waggle-sensor/wagman/boards/v2/README.md

# Wagman v2
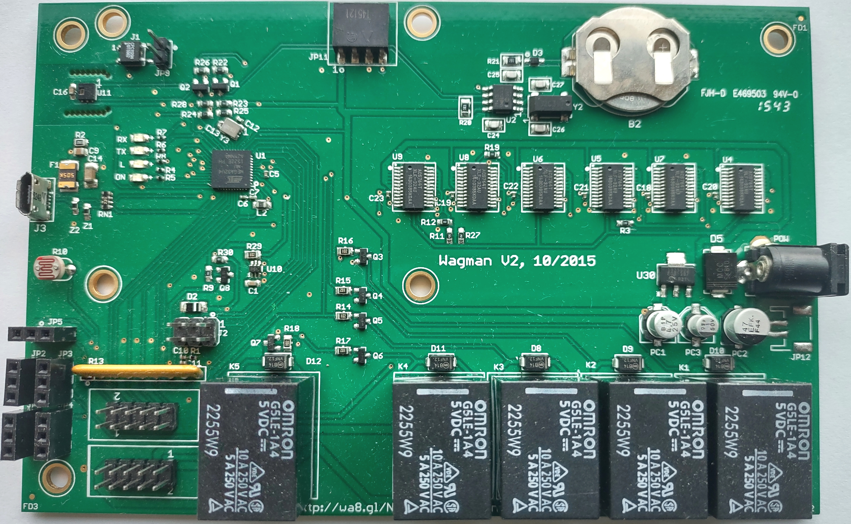
[picture p2: boards/v2/resources/wagman_v2-2.jpg]
</br>
Wagman v2 ([v2.1](https://github.com/waggle-sensor/wagman/raw/master/boards/v2/resources/wagman_v2-1.jpg) and [v2.2](https://github.com/waggle-sensor/wagman/raw/master/boards/v2/resources/wagman_v2-2.jpg) ) is built around a [ATmega32U4](https://www.microchip.com/en-us/product/ATmega32U4). It provides 5 channel power control using relays, current measurement (ACS764), Temperature and Humidity sensor (HTU21D and HIH4030), RTC (MCP79412), light sensor and 5V outputs. Wagman v2 is a prototype and system demonstrator, and is built to work with Odroid [C1+](https://www.hardkernel.com/shop/odroid-c1/) and [XU4](https://www.hardkernel.com/shop/odroid-xu4-special-price/) SBCs, providing special circuits for mnaging boot-media.
