waggle-sensor/wagman/boards/v4/firmware/develop/README.md

# Develop Notes

Currently porting communication to waggle protocol.
