waggle-sensor/wagman/boards/v2/supportcodes/Notes/Program SysMon.odt

- Connect AVR programmer to ICSP header on SysMon board (and to USB on your computer)
- Call avrdude program
  - terminal >> avrdude -option1 -option2 …
    - The following is an example of what Arduino calls to program a chip without a bootloader:
      - /opt/arduino-1.6.4/hardware/tools/avr/bin/avrdude -C/opt/arduino-1.6.4/hardware/tools/avr/etc/avrdude.conf -v -patmega32u4 -cstk500v2 -Pusb -Uflash:w:/home/danny/repos/git/waggle/wagman/manager/sysmanager/bin/sysmanager.cpp.hex:i
      - For an explanation of those options, see avrdude documentation
      - The .hex file is the firmware file that you're trying to burn onto the chip
- If you'd like to burn the Arduino bootloader onto the chip:
  - Connect AVR programmer
  - Launch Arduino IDE (you may need sudo)
  - Go to Tools > Burn Bootloader
