waggle-sensor/wagman/boards/v3/manager/qa_testing/design_dev_tests/Wagman_C1P_Bootswitch/README.md

# Test Scope and Coverage

This test evaluates the following aspects of Wagman system design. </br>
*   The ability to connect the boot-pins of the C1+ or isolate them toward
    changing the primary boot-up media. </br>
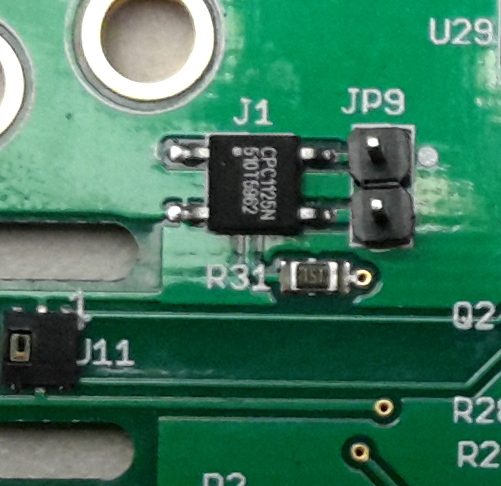
[picture p9: boards/v3/manager/qa_testing/design_dev_tests/Wagman_C1P_Bootswitch/resources/C1PBootSwitch.jpg]

*   Default boot media must be uSD, which is achieved by connecting the bootpins.
</br>

# Test Setup Procedure

*This test requires additional equipment. A multi-meter with continuity test capability in audible beep mode
to signify continuity is required.*

## Test Events Timeline
* The test starts with a Wagman that is not connected to power or the QA computer.
* Wagman is loaded with firmware and the toggling ability is tested.

## Electrical Connection
*  Connect micro-USB cable between Wagman's J3 and QA computer.
*  Connect 5V DC power to Wagman.

__Please make sure only the Wagman under test is connected to the QA computer. No other Wagman or Arduino Micro/derivatives can be connected at this time.__

## Testing Procedure
*   On an unpowered Wagman that is not connected to the QA computer, check the continuity between the two
    pins of JP9.</br>
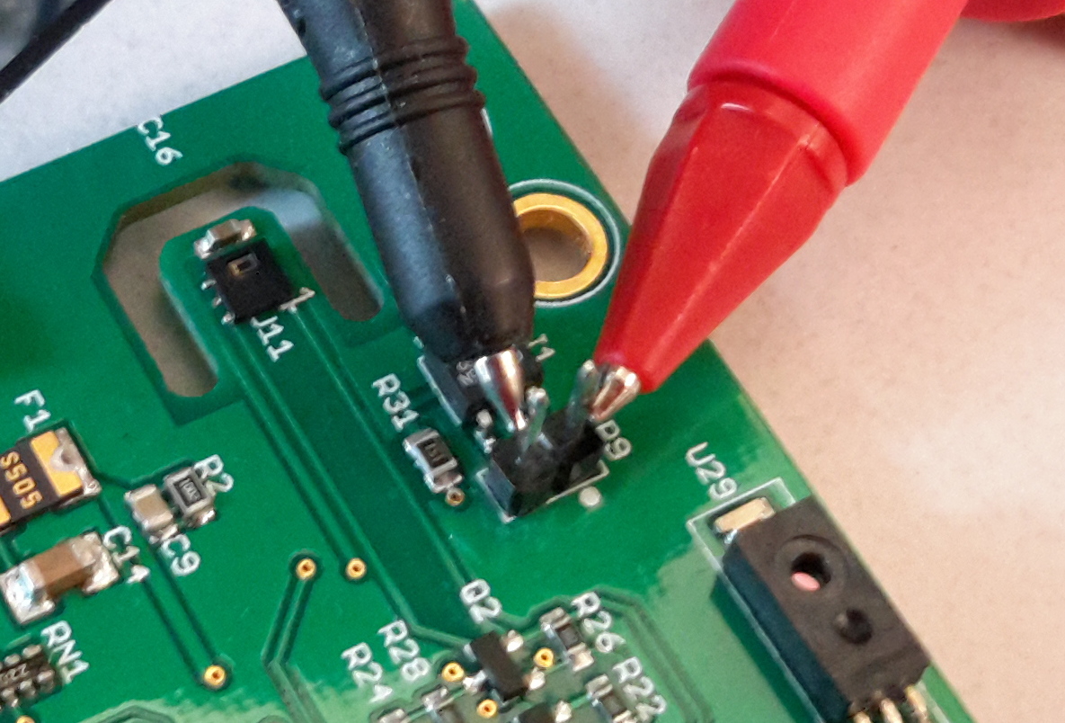
[picture p10: boards/v3/manager/qa_testing/design_dev_tests/Wagman_C1P_Bootswitch/resources/C1P_BootSelect.jpg]
 	
*   Connect the Wagman to QA computer and power it ON.
*   Start the second phase of the test by issuing the command *make test* in the Wagman subfolder
    and follow the on-screen prompts.

    __To exit the screen session created for the test, press Control+a, followed by k and y.__

## Test Log
This test is evaluated and scored on the __Wagman QA Scoresheet__.

# Success Criteria
The test is considered __PASSED__ if all the subtests under the Wagman C1P Boot Selector Test pass.
