waggle-sensor/wagman/boards/v3/manager/qa_testing/design_dev_tests/Wagman_Sensors/README.md

# Test Scope and Coverage

This test evaluates the following aspects of Wagman system design. </br>
*   The proper wiring of on-board sensors.
    -   HTU21D</br>
    
    -   HIH4030</br>
    
    -   Five Thermistors, four of which are sampled using MCP3428 A/D converter</br>
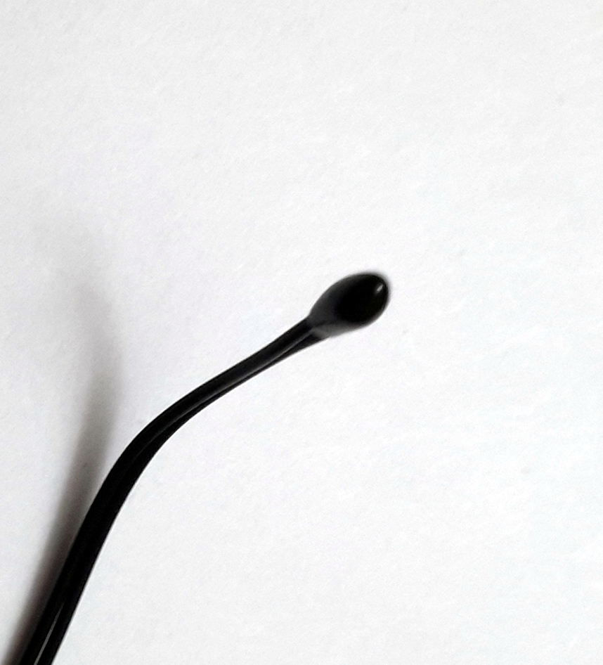
[picture p22: boards/v3/manager/qa_testing/design_dev_tests/Wagman_Sensors/resources/Thermistor.jpg]
    
    -   Optoresistor</br>
    
*    The functioning of the on-board sensors.
</br>

# Test Setup Procedure

## Test Events Timeline
* Wagman is loaded with firmware and the sensor test is conducted.

## Electrical Connection
*  Connect the two leads of the thermistors to PINS 5 and 6 of J5, J6, J7, J8 and J9 as shown below.
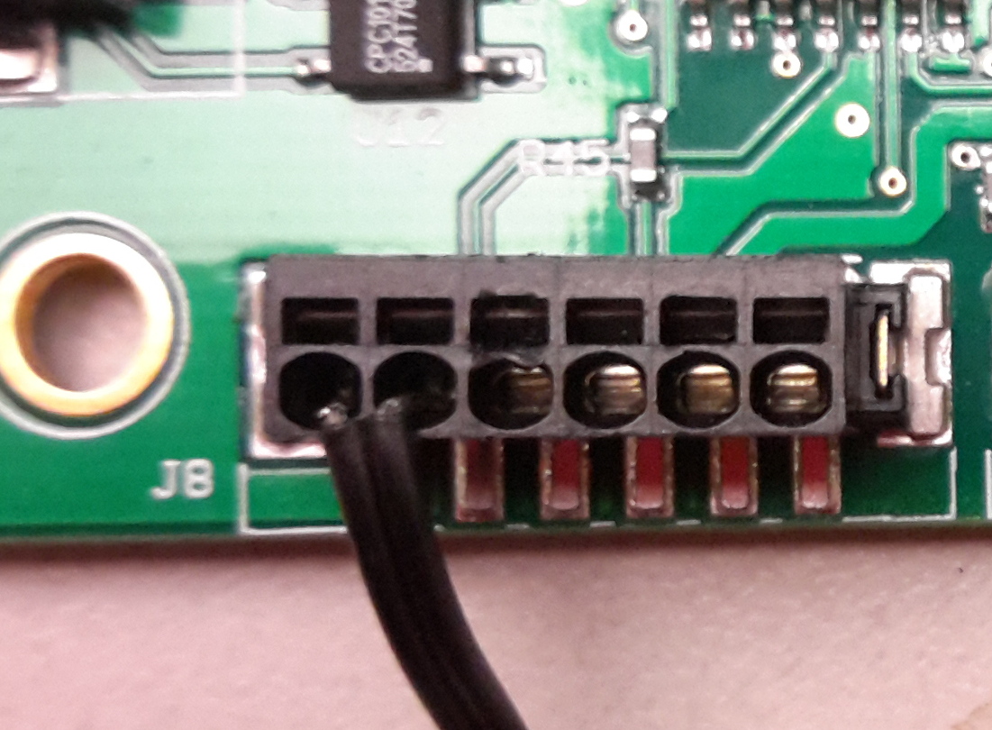
[picture p23: boards/v3/manager/qa_testing/design_dev_tests/Wagman_Sensors/resources/Thermistor_wiring.jpg]

*  Connect micro-USB cable between Wagman's J3 and QA computer.
*  Connect 5V DC power to Wagman.

__Please make sure only the Wagman under test is connected to the QA computer. No other Wagman or Arduino Micro/derivatives can be connected at this time.__

## Testing Procedure
*   Start the test by issuing the command *make test* in the Wagman subfolder
    and follow the on-screen prompts.

    __To exit the screen session created for the test, press Control+a, followed by k and y.__

## Test Log
This test is evaluated and scored on the __Wagman QA Scoresheet__.

# Success Criteria
The test is considered __PASSED__ if all the subtests under the Environmental Sensors Test pass.
