waggle-sensor/wagman/boards/v2/supportcodes/Notes/WagMan Tests.odt

WagMan Tests

Test Group | Test Description | Test Methodology | Pass/Fail
Primary boot sequence | Multiple attempts at primary boot sequence | Disconnect heartbeat from NC until SysMon tries another boot. Reconnect heartbeat and see if everything boots. | pass
| Going to sleep | Disconnect heartbeat from NC and leave it until SysMon goes to sleep. | fail
| All EEPROM defaults set correctly | Go thru list and make sure every variable is being assigned a default. | pass
| Parameters transferred correctly from NC | Print the value of an EEPROM read after receiving the parameters. | pass
| Time transferred correctly from NC | Print the time received from NC. | pass
Boot SysMon | Bad power | Set default EEPROM value to zero. | pass
| Bad environment | Set default EEPROM values to something outside the ambient range. | pass
Boot NC | Bad power | Set default EEPROM value to zero. | pass
| Bad power resulting in permanent disable | With the EEPROM value at zero, let SysMon disable NC. Reboot SysMon and see if it attempts to boot NC. | pass
| Bad environment | Set default EEPROM values to something outside the ambient range. | pass
| Bad temperature | Set default EEPROM values to something outside the ambient range. | pass
| Bad heartbeat | Disconnect heartbeat from NC and wait for power cycle. Reconnect heartbeat and see if it boots correctly. | pass
Boot ethernet switch | Bad power | Set default EEPROM value to zero. | pass
| Bad power resulting in permanent disable | With the EEPROM value at zero, let SysMon disable the switch. Reboot SysMon and see if it attempts to boot the switch. | pass
| Bad temperature | Set default EEPROM values to something outside the ambient range. | pass
Boot guest nodes (1, 2, 3) | Bad power | Set default EEPROM value to zero. | pass
| Bad power resulting in permanent disable | With the EEPROM value at zero, let SysMon disable GN. Reboot SysMon and see if it attempts to boot GN. | pass
| Bad temperature | Set default EEPROM values to something outside the ambient range. | pass
| Bad heartbeat | Disconnect heartbeat from GN and wait for power cycle. Reconnect heartbeat and see if it boots correctly. | pass
Main loop | Status report | Verify contents of status report received by NC. | pass
| Time report | Verify contents of time report received by NC. | pass
| Problem report | Verify contents of problem report received by NC. Some of the other tests should cause problem reports to be sent. | pass
| All timeouts being responded to | Cause each timeout by setting values to something ridiculous and overriding boot checks. | pass
| Reboot devices | Cause a timeout for each device and see if it SysMon reboots it after awhile. Also need to make sure normal operation resumes smoothly after the delay of waiting for something to boot. | pass
WagMan on NC | Heartbeat output | Verify heartbeat on the oscilloscope. | pass
| Store status report | Write status report to file. | pass
| Store problem report | Write problem report to file. | pass
| Configure (and communicate with SysMon) correctly | Run configure script on NC and see if status messages are eventually being sent to NC. | pass
