waggle-sensor/wagman/boards/v3/utils/manager/evaluator/README.md

<!--
waggle_topic=IGNORE
-->

The Wagman evaluation code documentation goes here.
