waggle-sensor/wagman/boards/v2/supportcodes/tests/evaluator/README.md

The Wagman evaluation code documentation goes here.
