waggle-sensor/wagman/boards/v4/errata/errata_V4.03.md

## Wagman 4.0 Power up and Testing 

## Enhancements:

* Add mechanism to read BOOTPULSE signal on the Atmel. We talked about using a high-impedence decoupler so the Atmel can't accidentally change the pin mode to output and affect BOOTPULSE's behavior.
