waggle-sensor/wagman/(threads)

Thread 1 (2016-06-24):

Watchdog / Bootloader Lockup

seanshahkarami, 2016-06-24:
Under some conditions, it seems like the watchdog enters a state such that immediately after the boot loader finishes, it reboots the device.

seanshahkarami, 2016-06-24:
This seems to have been solved by clearing the MCUSR flags before doing another `wdt_enable` in setup.

Closed 2016-06-24.

Thread 2 (2016-06-28):

Verify Port Address Mappings

seanshahkarami, 2016-06-28:
This is just a final reminder to walk through a check that all the sensors (thermistors / current sensors / heartbeat) and make sure that they are mapped correctly to the ports.

MuffinSpawn, 2016-09-23:
Issue moved to [waggle-sensor/development #27](https://github.com/waggle-sensor/development/issues/27) via [**ZenHub**](https://www.zenhub.com/)

Closed 2016-09-23.

Thread 3 (2016-06-28):

Need self check for PORF case.

seanshahkarami, 2016-06-28:
When the Wagman powers on, would like to add a quick self check and sensor range check. (The reason for doing it in this case, in particular, is that no devices will be on yet.)

MuffinSpawn, 2016-09-23:
Issue moved to [waggle-sensor/development #26](https://github.com/waggle-sensor/development/issues/26) via [**ZenHub**](https://www.zenhub.com/)

Closed 2016-09-23.

Thread 4 (2016-06-28):

Correct behavior for log messages sent in between commands.

seanshahkarami, 2016-06-28:
The logger current sends some info in between commands run in the Wagman shell. It's not a major issue since they just show up inside another command output but I would like to clean up the behavior of that.

MuffinSpawn, 2016-09-23:
Issue moved to [waggle-sensor/development #25](https://github.com/waggle-sensor/development/issues/25) via [**ZenHub**](https://www.zenhub.com/)

Closed 2016-09-23.

Thread 5 (2016-06-28):

Verify Boot Selection Cycle

seanshahkarami, 2016-06-28:
We just need to make sure that the devices are correctly cycled through the primary / secondary boot media on bad starts.

seanshahkarami, 2016-06-28:
Ok...part of this was me being dumb. I forgot that I temporarily removed the `incrementBootFailures` line when cleaning up the code...

seanshahkarami, 2016-06-28:
I just extended override boot media command. This should help with testing and also allow the node controller to make some choices about how devices will be started. 😄

MuffinSpawn, 2016-09-23:
Issue moved to [waggle-sensor/development #24](https://github.com/waggle-sensor/development/issues/24) via [**ZenHub**](https://www.zenhub.com/)

Closed 2016-09-23.

Thread 6 (2016-06-28):

Sync EEPROM memory layout in code and what's in layout document.

seanshahkarami, 2016-06-28:
Because of changes which have cropped up in development, I need to sync these pieces up.

MuffinSpawn, 2016-09-23:
Issue moved to [waggle-sensor/development #23](https://github.com/waggle-sensor/development/issues/23) via [**ZenHub**](https://www.zenhub.com/)

Closed 2016-09-23.

Thread 7 (2016-06-28):

Stop disabled devices showing up in logging / update loop.

seanshahkarami, 2016-06-28:
This is just a reminder for me to add a check against running things on disabled devices...

MuffinSpawn, 2016-09-23:
Issue moved to [waggle-sensor/development #22](https://github.com/waggle-sensor/development/issues/22) via [**ZenHub**](https://www.zenhub.com/)

Closed 2016-09-23.

Thread 8 (2016-06-28):

Split Stop / Reset Behavior

seanshahkarami, 2016-06-28:
I should make sure that the stop command also sets the disable flag on a device. And add a separate reset command.

MuffinSpawn, 2016-09-23:
Issue moved to [waggle-sensor/development #21](https://github.com/waggle-sensor/development/issues/21) via [**ZenHub**](https://www.zenhub.com/)

Closed 2016-09-23.

Thread 10 (2016-08-01):

SSH / Heartbeat

seanshahkarami, 2016-08-01:
Under what circumstances will a node controller continue to heartbeat Wagman but not be reachable via SSH?

seanshahkarami, 2016-08-01:
As with the modem, the heartbeat doesn't currently depend on the SSH tunnel.

MuffinSpawn, 2016-09-23:
Issue moved to [waggle-sensor/development #19](https://github.com/waggle-sensor/development/issues/19) via [**ZenHub**](https://www.zenhub.com/)

Closed 2016-09-23.

Thread 9 (2016-08-01):

Modem Hanging

seanshahkarami, 2016-08-01:
If the modem hangs, and only a power cycle will correct it, how does that scenario work?

seanshahkarami, 2016-08-01:
We could have the heartbeat process depend on more conditions being met such as the modem appearing to work, LAN connection showing up, etc.

Alternatively, if the NC detects something like this, it can just request to be reset.

MuffinSpawn, 2016-09-23:
Issue moved to [waggle-sensor/development #20](https://github.com/waggle-sensor/development/issues/20) via [**ZenHub**](https://www.zenhub.com/)

Closed 2016-09-23.

Thread 11 (2016-08-03):

Combined Current Behavior

seanshahkarami, 2016-08-03:
I just want to point out something I'd observed before but just realized a likely cause for.

I noticed that the current to the C1+ seemed to increase a little after the XU4 was powered on. After seeing the lights on the ethernet ports start blinking, I realized that it was likely a piece contributing to the "total being greater than the sum of parts". You can check this by unplugging the ethernet cable and seeing the current to the devices drop.

It's not a serious problem, but for anyone who ends up looking at this in the future, you'll probably witness this too. Ha...seems obvious now...

Closed 2016-08-03.

Thread 12 (2016-08-08):

Fail Safe Flag for Bootloader in EEPROM

seanshahkarami, 2016-08-08:
One feature request intended to make the flashing process a bit safer was to have a flag in EEPROM which the *bootloader* reads and uses to decide whether it should power on the node controller before running the main program.

The reason for this is that the bootloader is preserved when flashing the rest of the code on the Wagman, so it gives us a way to write a simpler, non-updatable piece to act as a failsafe for flashing the rest of the Wagman code. (For example, if we lost power during a flash, we could possibly be dead...)

seanshahkarami, 2016-08-08:
Bootloader reference code:
https://github.com/arduino/Arduino/tree/master/hardware/arduino/avr/bootloaders/atmega8

MuffinSpawn, 2016-09-23:
Issue moved to [waggle-sensor/development #18](https://github.com/waggle-sensor/development/issues/18) via [**ZenHub**](https://www.zenhub.com/)

Closed 2016-09-23.

Thread 13 (2016-08-15):

Verify that all reads have timeout.

seanshahkarami, 2016-08-15:
We realized that the MCP342 library did not include a timeout on the i2c read. This is corrected now, but we should verify that every case of this includes a timeout.

seanshahkarami, 2016-08-16:
This looks good now and additionally has a "breaker" feature that can disable i2c bus reads all together.

Closed 2016-08-16.

Thread 15 (2016-12-22):

Wagman V3.1 : Bootloader Install and Firmware Upgrade Issues

Rumpkie, 2016-12-22:
The latest run of wagman 3.1 boards and the older wagman 2s will not accept the latest version of the wagman software.

Symptoms:
the following error is generated:
```
avrdude: Expected signature for ATmega32U4 is 1E 95 87
Double check chip, or use -F to override this check.
```

The board will not accept the latest boot loader or any boot loader.

Rumpkie, 2016-12-22:
I have been able to get the bootloader to program on the ATMEGA32u4 by reducing the programmer's baud rate by editing the makefile and changing the `avrdude -B` flag from 1 to 2.
which drops the programming bit rate from 1Mhz to 500Khz.

While this did get passed the problem of burning the bootloader, it did not allow me to program the chips with the test software.  The issue becomes the command

`stty -F /dev/waggle_sysmon hupcl;`

which normally puts the ATMEGA32u4 into receive program mode doesn't seem to work, or doesn't seem to completely work. and while sometimes the avrdude can read the existing board it cannot seem to find the programmer or reports that the programmer has stopped responding when it goes to program it the script does try the programmer several times over the course of 10 seconds or so.

Rumpkie, 2016-12-22:
The initial thoughts of why this may be happening centered around a purchasing choice to move from the ATMEL part number ATMEGA32u4-MUR to ATMEGA32u4-MU, the thoughts there being that there was no difference in the chips. I have confirmed with both the supplier, DIGIKEY and the manufacture ATMEL that ATMEGA32u4-MUR to ATMEGA32u4-MU are the same chip and that one comes on a reel and the other a tray. This is further confirmed by the part number that is etched on, both the ATMEGA32u4-MUR and ATMEGA32u4-MU say ATMEGA32u4-MU.

Rumpkie, 2016-12-22:
Additional information: some of the older wagmans are programmable and when those chips are placed on the newer board they remain programmable so we have ruled out the prospect of it being something else on the board.

Rumpkie, 2017-01-09:
The initial state of the Atmel chip may not have the fuses properly set, the following line added at commit 63ee45d7f2b9cbcbe55420d20b721080452c2d91

`avrdude -C ./avrdude.conf -B 2 -p atmega32u4 -P usb -c avrispmkII -U efuse:w:0xcb:m  -U hfuse:w:0xd8:m -U lfuse:w:0xff:m -v -U flash:w:Caterina.hex`

sets the correct clock settings for the CPU

Closed 2017-01-09.

Thread 18 (2017-02-17):

Abstract out more of the scheduler / task code

seanshahkarami, 2017-02-17:
At the moment, the system has a lot of timers keeping tabs on when events should occur. Now, those are all kind of laid out in an ad-hoc way through different pieces of the system. It would be nice to write a central scheduler in charge of managing these things.

Some possible benefits I can think of off hand are:

* Easier reflection on where different events are in the system timeline. This could also be exposed to the user, so you can get a quick summary of where different events are on the timeline, and maybe even reschedule things manually.
* Having central control over all timing events would make it much easier to do things like pausing all tasks, or delay all start events by 5 minutes.
* If we ever move towards a "low power" system, the scheduler can more intelligently decide it wants to sleep until the next task needs to be run.
* Easier to spin up occasional one-off tasks. For example, during testing, you may want to ask the system to perform an action in 15 minutes. Having a centralize scheduler would make that much easier to implement.

seanshahkarami, 2017-09-04:
I started prototyping a couple different approaches to this as part of a generally purpose scheduler: https://github.com/seanshahkarami/scheduler

This kind of design could be _very_ helpful as it allows you to "step" timing and other events. This opens up the possibility of unit testing sequences of events to ensure correctness.

For example, you could simulate having a device in a particular state, then advance time until just before a transition to check if it's still in the same state, then advance time by one unit and check that a transition happened and that we're in the correct state. You can also unit test things like heartbeat / watchdog behavior with this.

Thread 20 (2017-02-17):

Background updating of environment sensors

seanshahkarami, 2017-02-17:
It *may* be nice to schedule the reading some the onboard environment sensors (temperature, humidity, current, thermistors) as a "background" process which can progressively cycle through the list of sensors and do various device writes / read in a nonblocking way and then cache the results or errors that occur.

This *could* help prevent the main logic from ever getting blocked and would always have a recent reading of a sensor value or error ready.

Thread 22 (2017-02-17):

Clean up the way devices / hardware are modeled

seanshahkarami, 2017-02-17:
The way the devices are modeled now doesn't really make much sense. For example, all devices are assumed to have a boot media selector. I think this was a side effect of trying to unify what features a device should have way too early. It’s probably better just to accept their quirks and model behavior as a few independent components, then keep a few different kind of state machines depending on the device type.

Another facet of this is, too much logic is groups under either the `Device.cpp` or `Wagman.cpp` files. For example, the idea of a "circuit breaker" relay should probably be developed as its own component and can persist its own state, the idea of a device state machine should be its own thing with transitions on some well defined events.

Thread 26 (2017-02-17):

Document the main processes

seanshahkarami, 2017-02-17:
There should be some high level documentation of what's happening in the system and what you should expect to see at every stage. This would be useful, not only to be able to hand off to some one else, but also as a general resource to help someone understand how the system should behave and respond under different circumstances.

Even for now, something simple thing like the following could be helpful:

Bootloader starts:
1. Powers NC on failsafe media if early NC power flag enabled.
2. Start setup process.

Setup process:
1. Get and clear boot flags.
2. Enable reset the watchdog.
3. Setup persistant records.
4. Setup hardware / sensors.
5. Update boot time and counts.
6. Setup device states.
7. Start main process.

Main process:
1. Start next device, if start timer expired.
2. Update device processes.
3. Process commands.
4. Send logs every 60 seconds.
5. Reset system, if reset requested.
6. Reset watchdog.

Device process (normal operation):
...will add more...

Device process (failsafe operation / 30+ failures):
Every 4 hours, the device is killed and then started on its other boot media.

Thread 27 (2017-03-13):

Add more sensible bounds on certain timers

seanshahkarami, 2017-03-13:
There are a few places which I'd like to revisit to limit how bad we'd be affected by a long timeout set by the user.

One example of this is the stop command. You're able to pass a parameter indicating how long the system should wait before stopping a device. If you run that with a really large time parameter and and shutdown the node controller, then currently in the worst case, you'd have to wait about 50 days to see it come back up.

I think it'd be reasonable to limit these parameters for something like 30 minutes or an hour at most for safety reasons.

Thread 28 (2017-03-23):

Add command acknowledgments for each part of the communication pipeline.

seanshahkarami, 2017-03-23:
After revisiting this, I remembered that in the driver-to-wagman part of the communications, I'd designed a message delimiting structure for message exchange.

This already adds an acknowledgement for this piece of the pipeline.

seanshahkarami, 2017-03-24:
An ack mechanism kind of exists in the client-to-driver piece in that a random correlation id is generated and sent along with a message. The client only accepts the output if that correlation id shows up in a response message, otherwise it times out.

seanshahkarami, 2017-03-24:
Finally, wagman itself indicates whether of command was actually a valid command or not.

seanshahkarami, 2017-03-24:
We can still revisit the issue later, but I think in light of these three things, there's already quite a bit of acknowledgement built-in. One are to improve is providing a more uniform and thorough indication of errors, though. Currently this is handled by printing ad-hoc error messages or timing out.

Closed 2017-03-24.

Thread 29 (2018-03-19):

Working Wagman now stuck in bootloader

seanshahkarami, 2018-03-19:
## Setup
* Standard open box node
* Wagman fully functional prior to issue
* Wagman with modified BOL (need to check threshold)
* Wagman with modified filter block

## Symptom

During power cycling test, Wagman hung. After manually power cycling node, Wagman stuck in bootloader w/ pulsing green light.

## Notes

During relay power cycle test, last log from Wagman indicated a BORF + PORF after reset.

seanshahkarami, 2018-03-19:
[Postmortem](https://github.com/waggle-sensor/devOps/blob/master/debugging/wagman-2018-03.md)

Closed 2018-03-19.
