waggle-sensor/wagman/boards/v5/pcb/WAGMAN5-V1-1-FAB.pdf

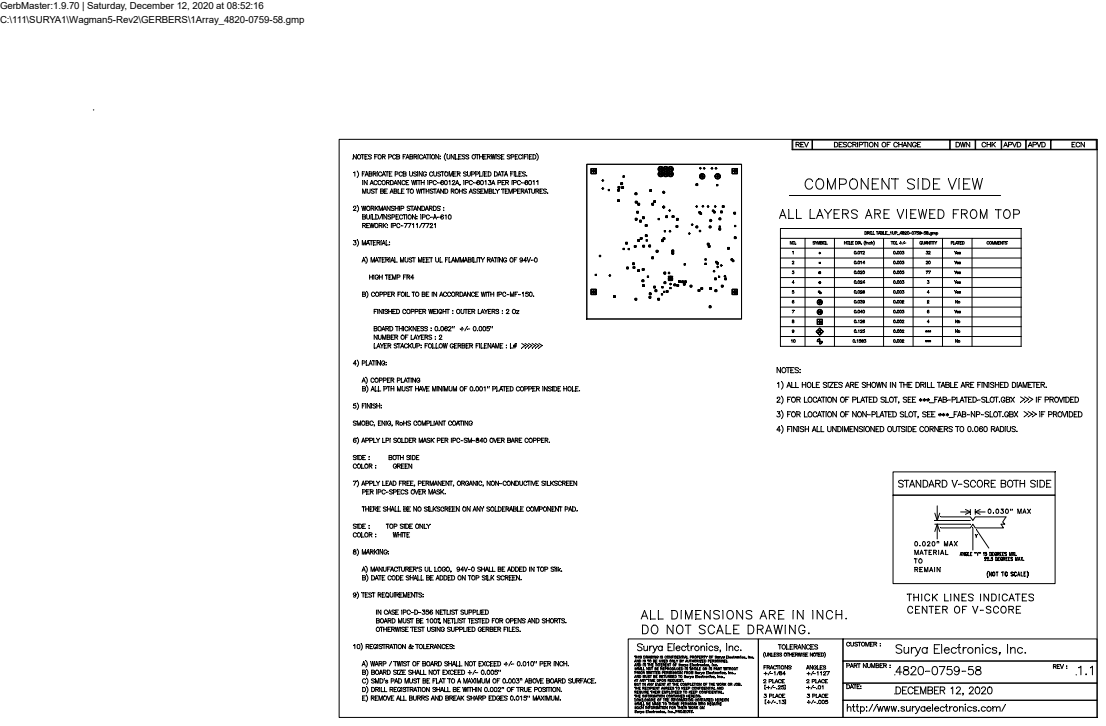
[picture p26: page 1]

GerbMaster:1.9.70 | Saturday, December 12, 2020 at 08:52:16
C:\111\SURYA1\Wagman5-Rev2\GERBERS\1Array_4820-0759-58.gmp
