waggle-sensor/wagman/boards/v5/pcb/WAGMAN5-V1-1-GBR.pdf

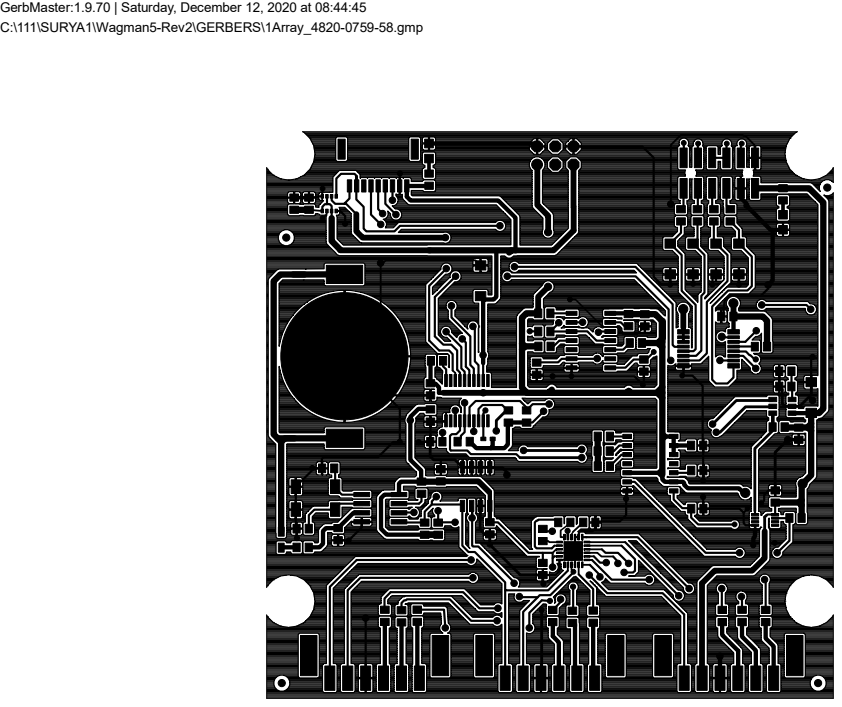
[picture p27: page 1]

GerbMaster:1.9.70 | Saturday, December 12, 2020 at 08:44:45
C:\111\SURYA1\Wagman5-Rev2\GERBERS\1Array_4820-0759-58.gmp

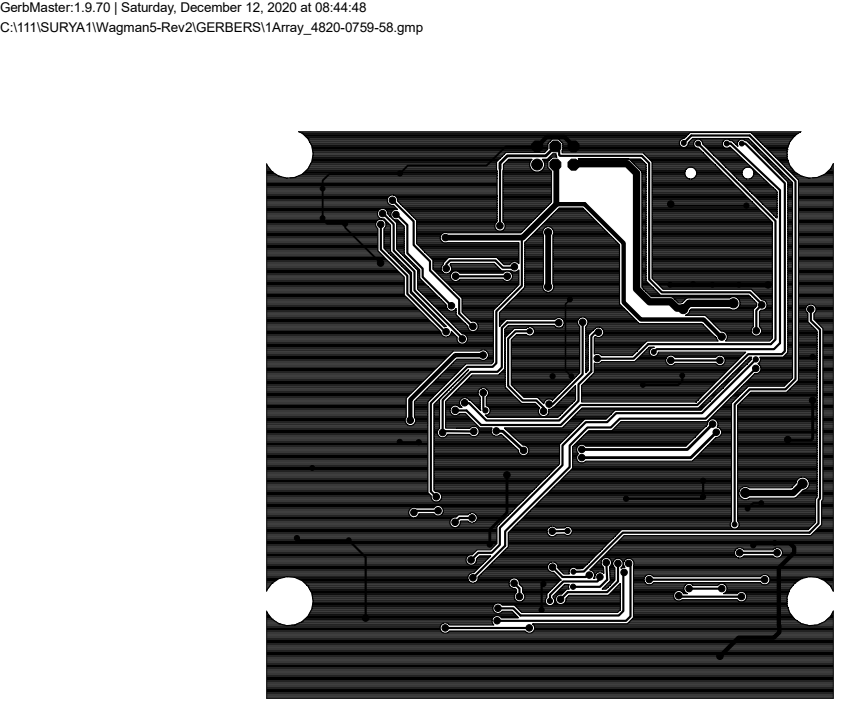
[picture p28: page 2]

GerbMaster:1.9.70 | Saturday, December 12, 2020 at 08:44:48

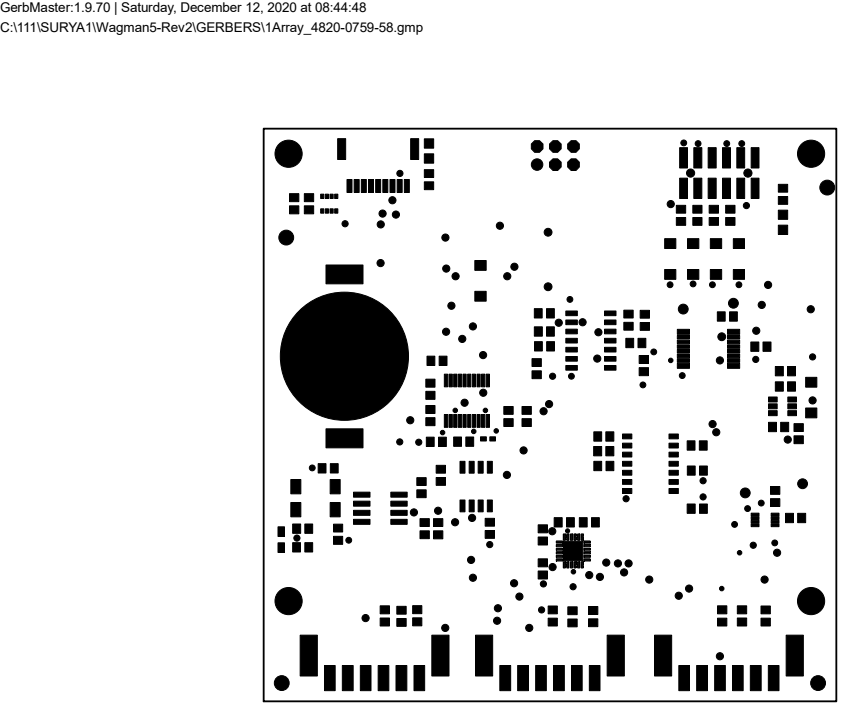
[picture p29: page 3]

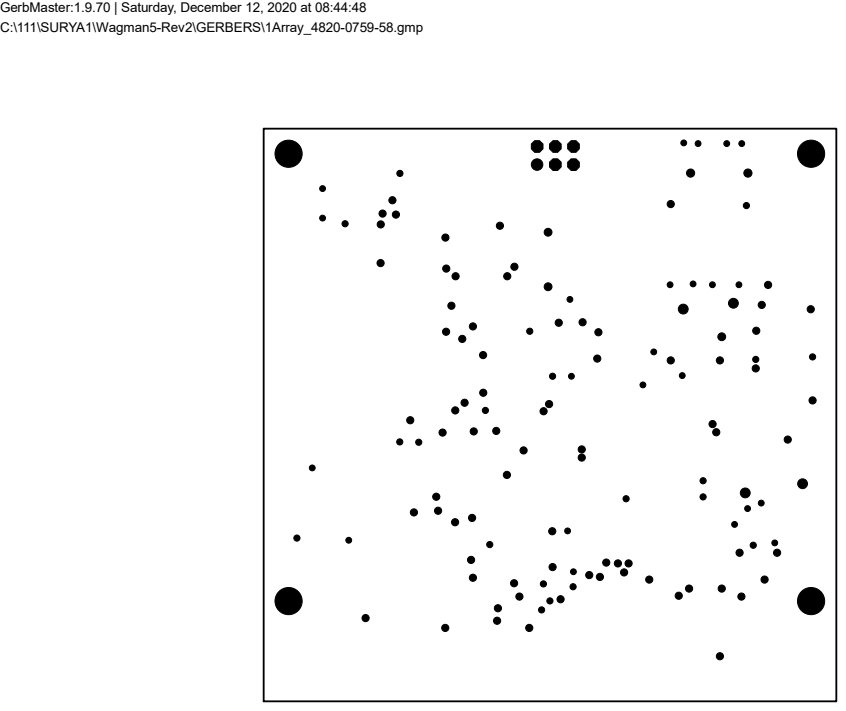
[picture p30: page 4]

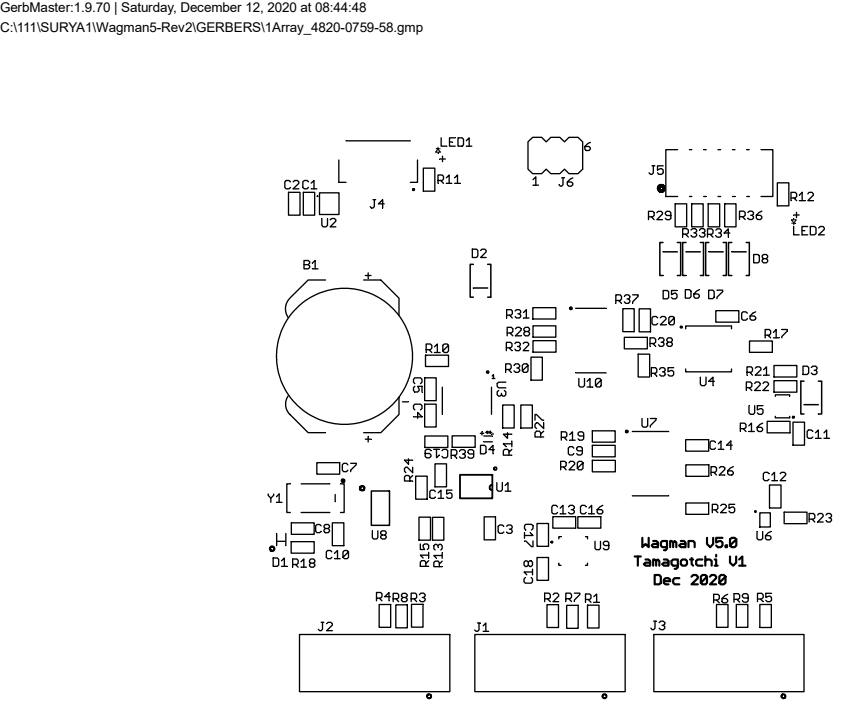
[picture p31: page 5]

GerbMaster:1.9.70 | Saturday, December 12, 2020 at 08:44:49

GerbMaster:1.9.70 | Saturday, December 12, 2020 at 08:44:49

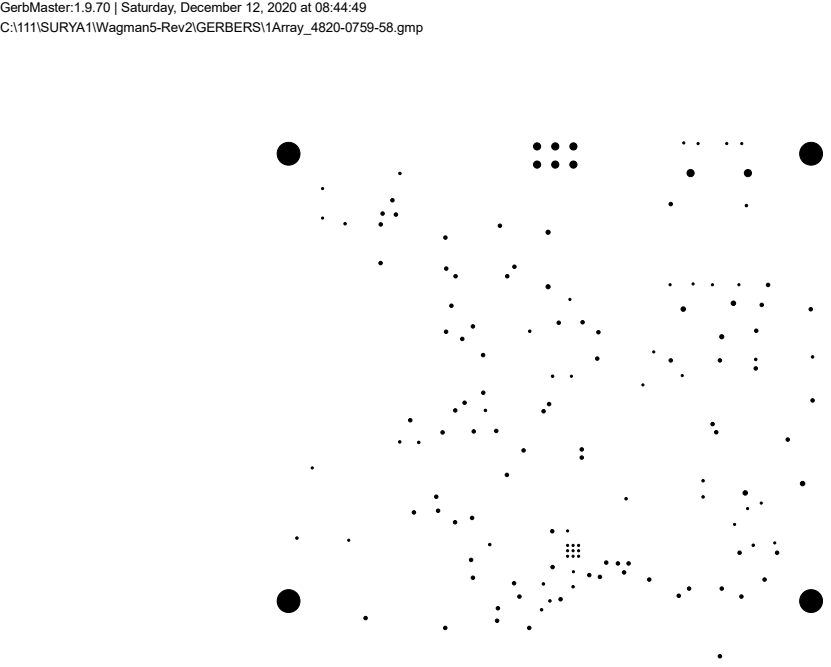
[picture p32: page 9]

GerbMaster:1.9.70 | Saturday, December 12, 2020 at 08:44:49
