waggle-sensor/wagman/boards/v4/pcb/v4/4820-0759-56_ARRAY-GBR.pdf

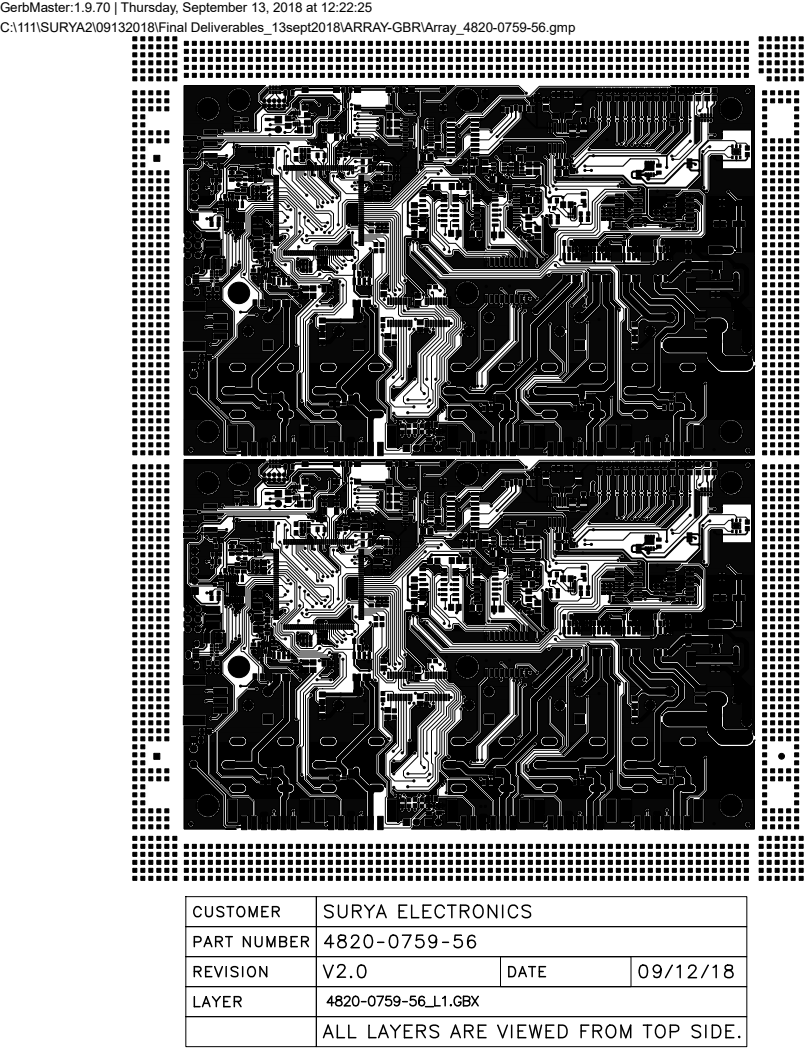
[picture p33: page 1]

GerbMaster:1.9.70 | Thursday, September 13, 2018 at 12:22:25
C:\111\SURYA2\09132018\Final Deliverables_13sept2018\ARRAY-GBR\Array_4820-0759-56.gmp

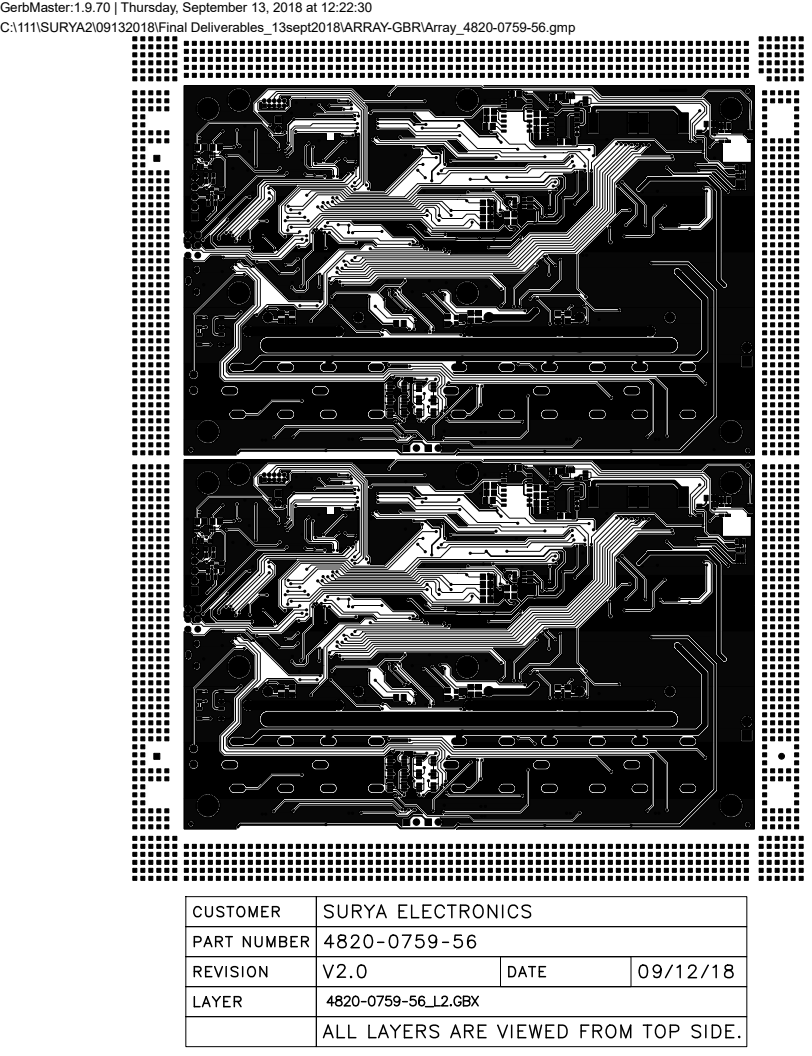
[picture p34: page 2]

GerbMaster:1.9.70 | Thursday, September 13, 2018 at 12:22:30

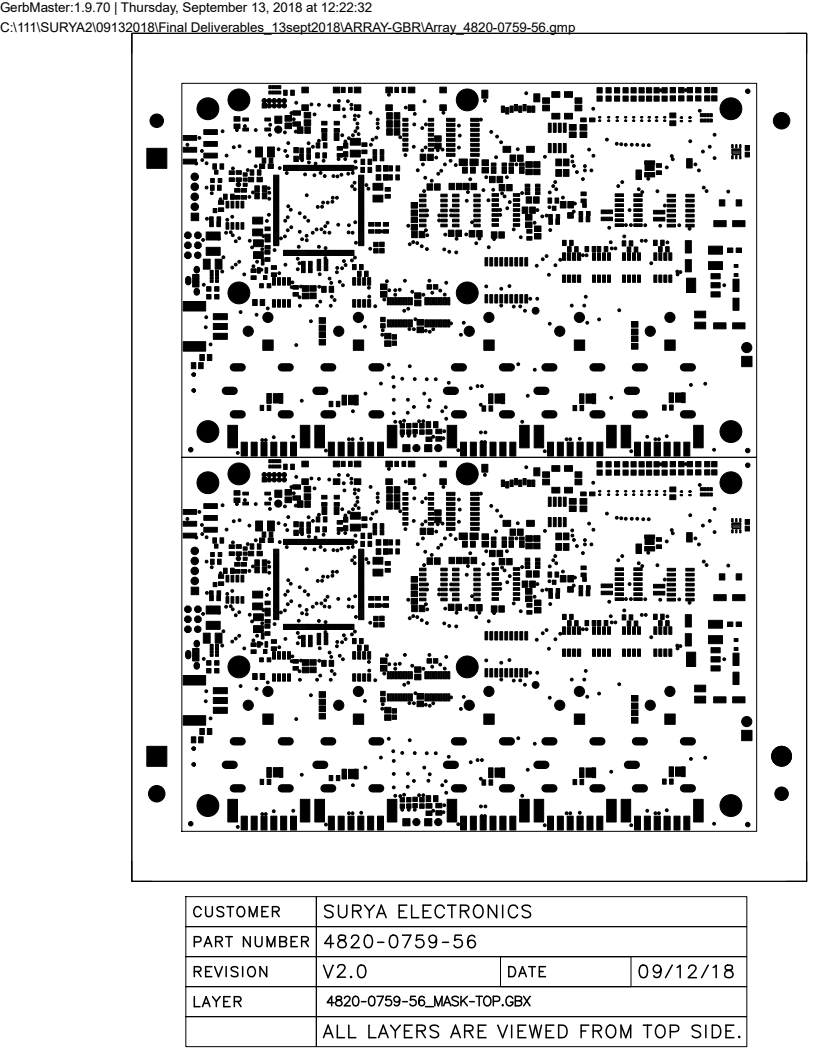
[picture p35: page 3]

GerbMaster:1.9.70 | Thursday, September 13, 2018 at 12:22:32

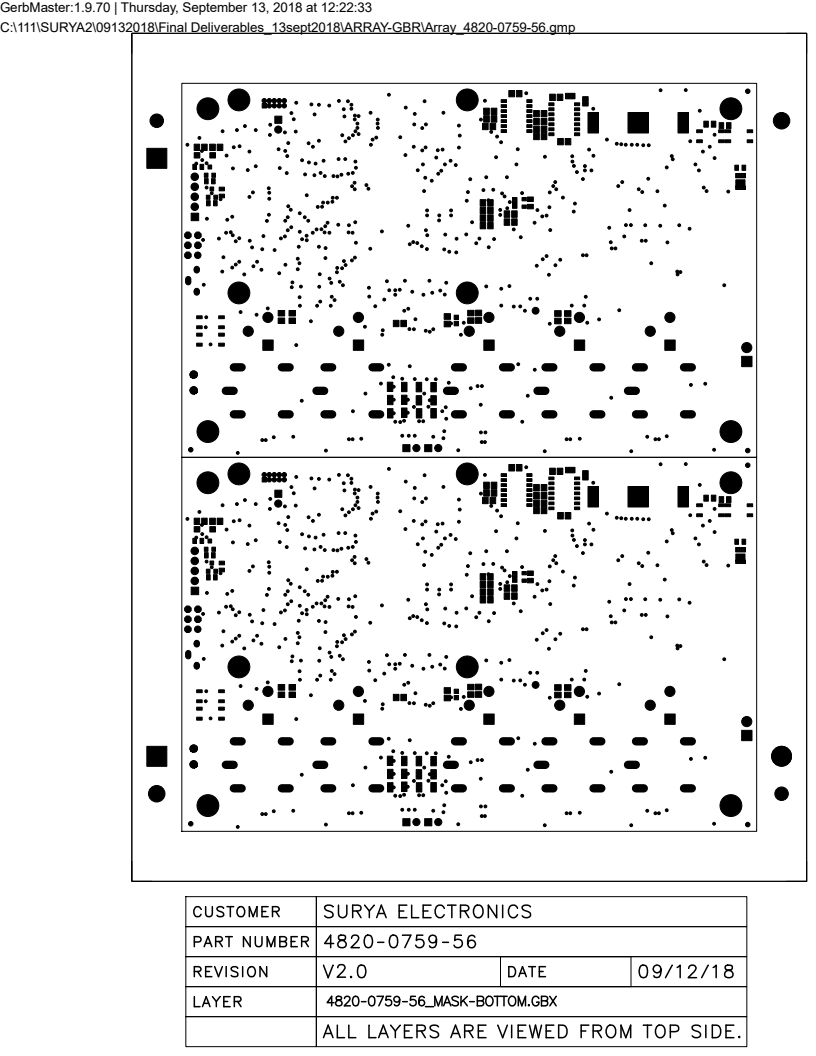
[picture p36: page 4]

GerbMaster:1.9.70 | Thursday, September 13, 2018 at 12:22:33

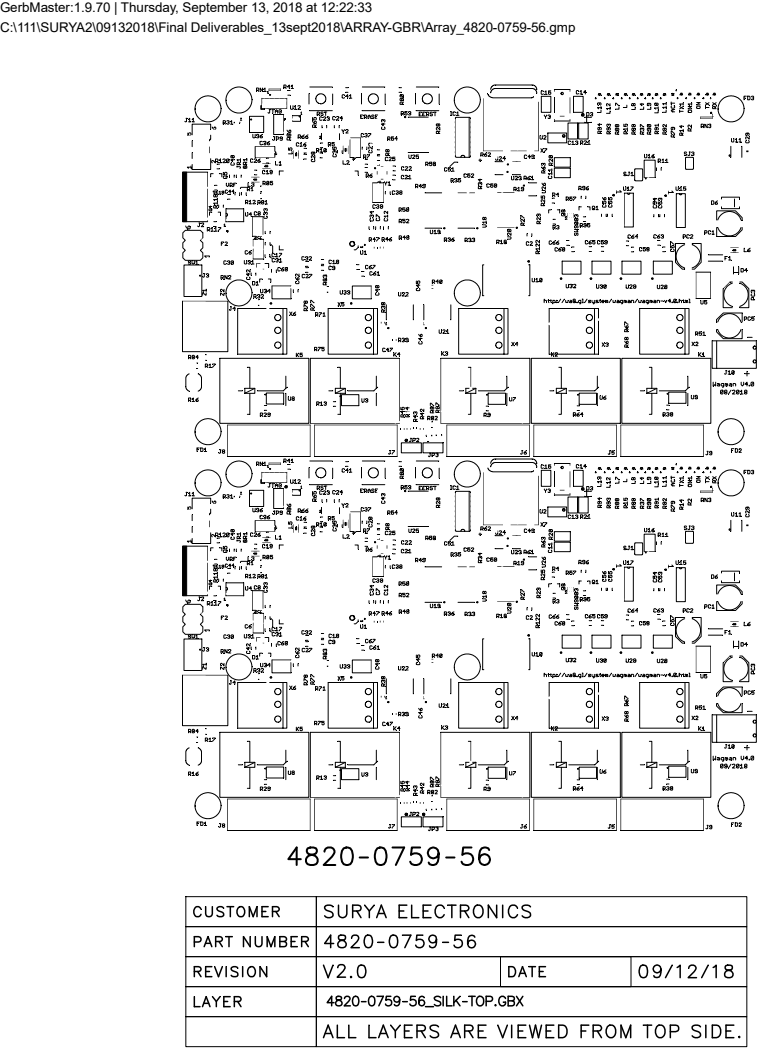
[picture p37: page 5]

GerbMaster:1.9.70 | Thursday, September 13, 2018 at 12:22:33

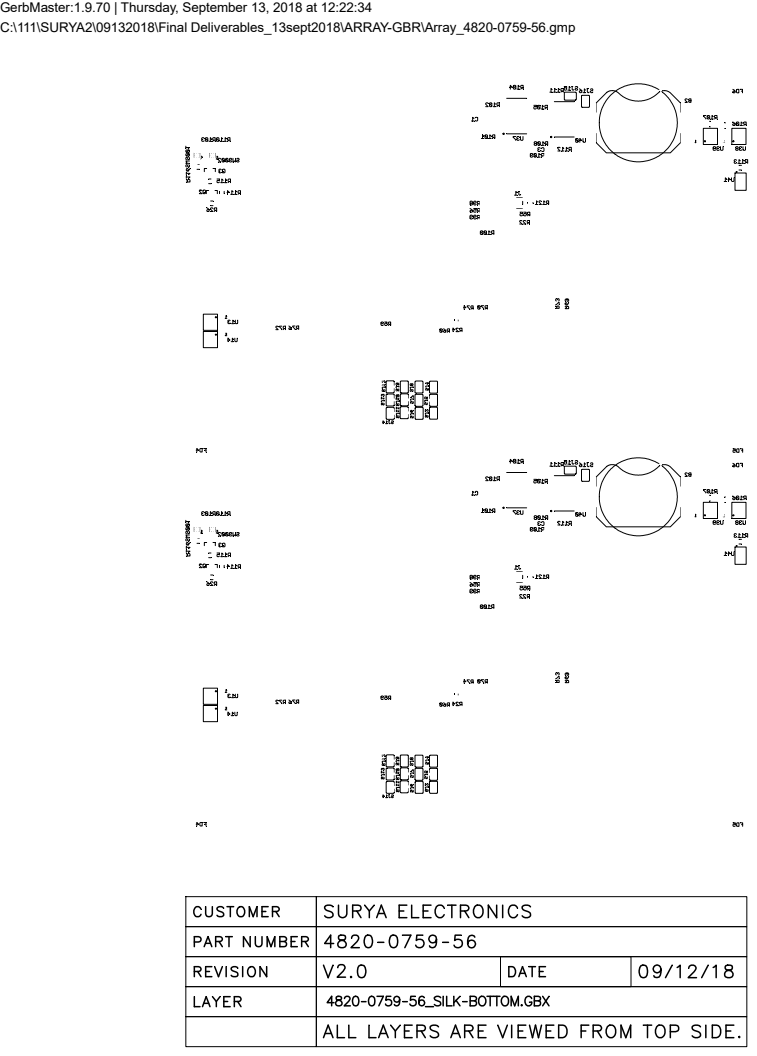
[picture p38: page 6]

GerbMaster:1.9.70 | Thursday, September 13, 2018 at 12:22:34

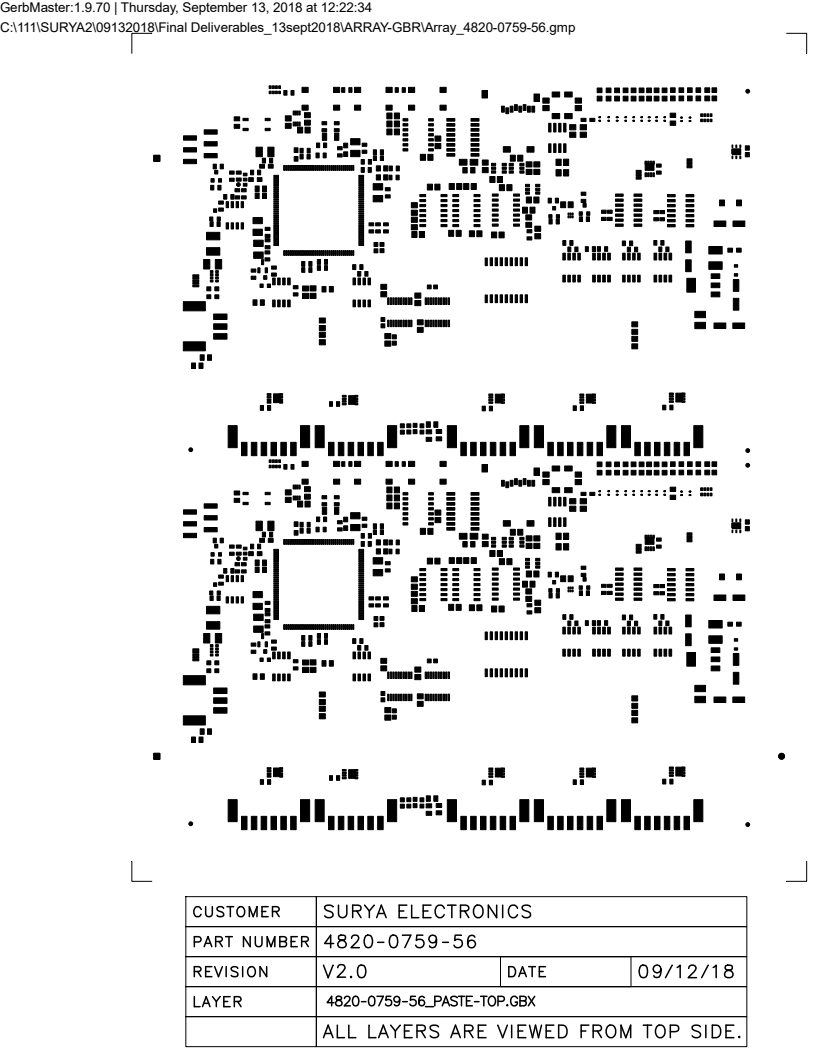
[picture p39: page 7]

GerbMaster:1.9.70 | Thursday, September 13, 2018 at 12:22:34

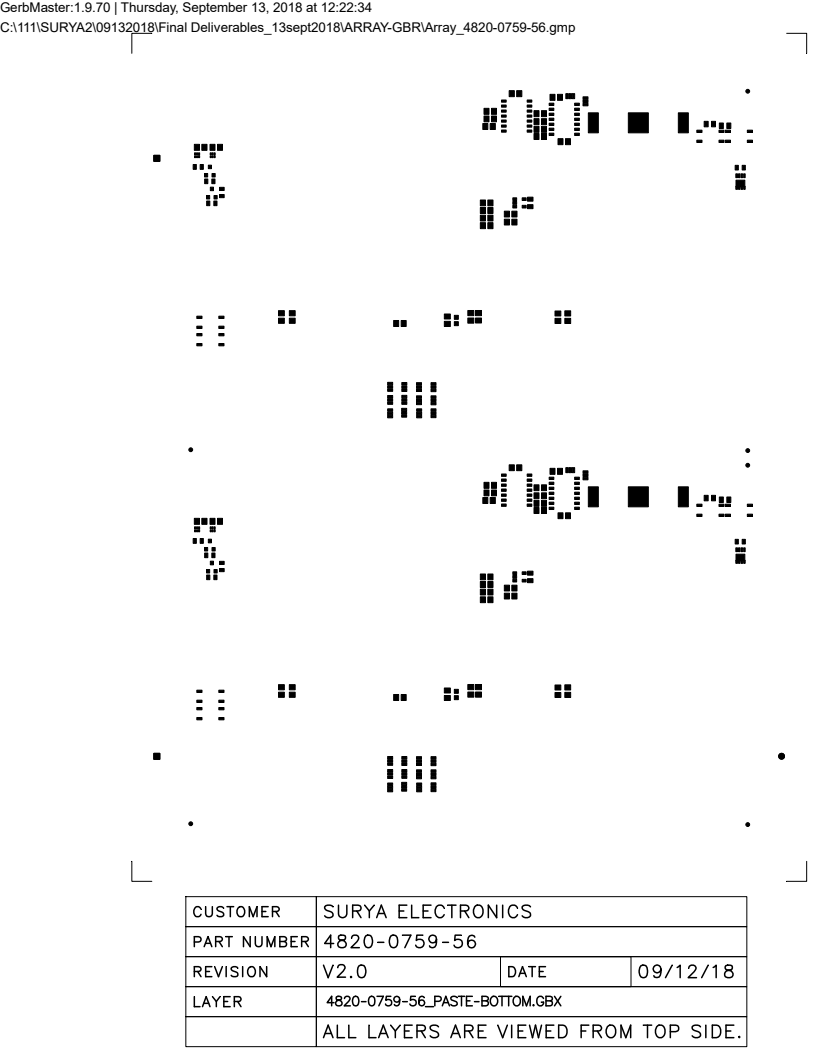
[picture p40: page 8]

GerbMaster:1.9.70 | Thursday, September 13, 2018 at 12:22:34

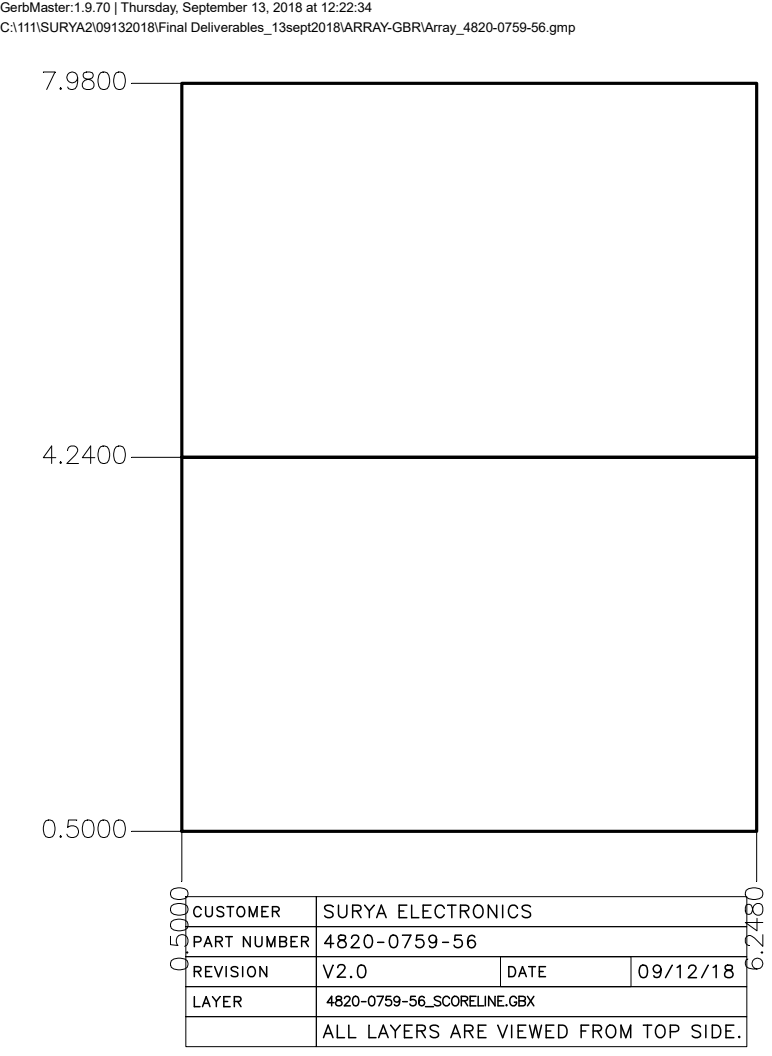
[picture p41: page 9]

GerbMaster:1.9.70 | Thursday, September 13, 2018 at 12:22:34

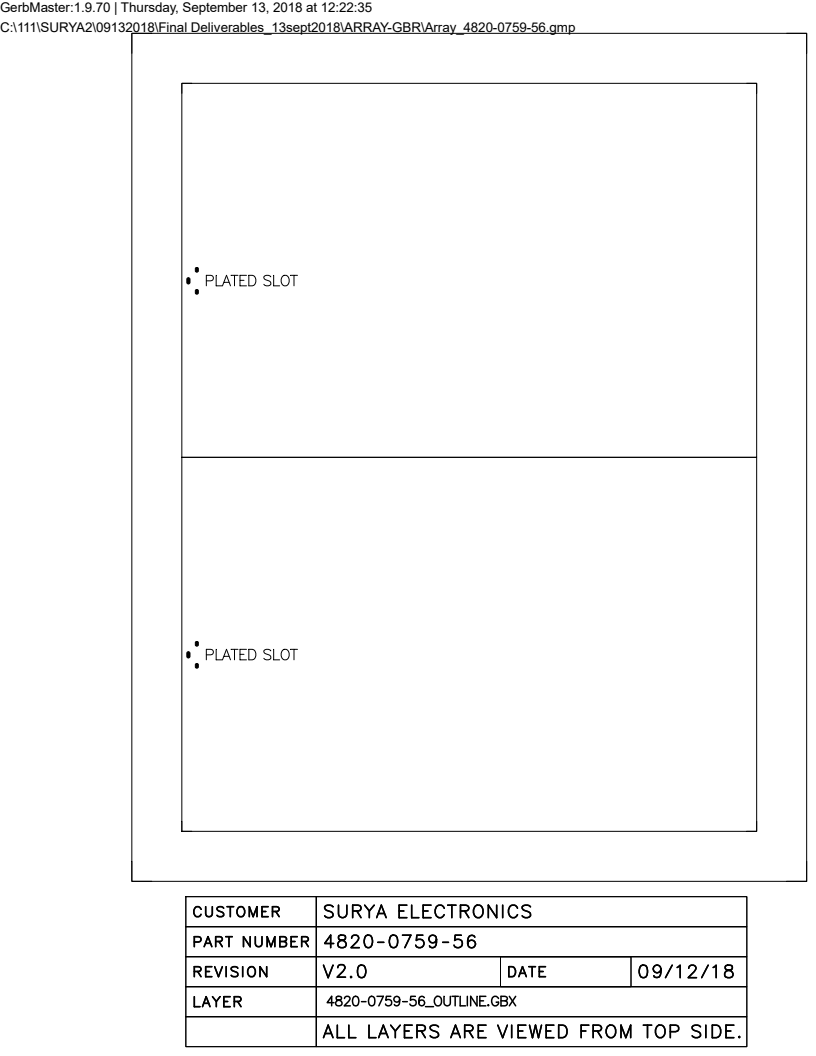
[picture p42: page 10]

GerbMaster:1.9.70 | Thursday, September 13, 2018 at 12:22:35

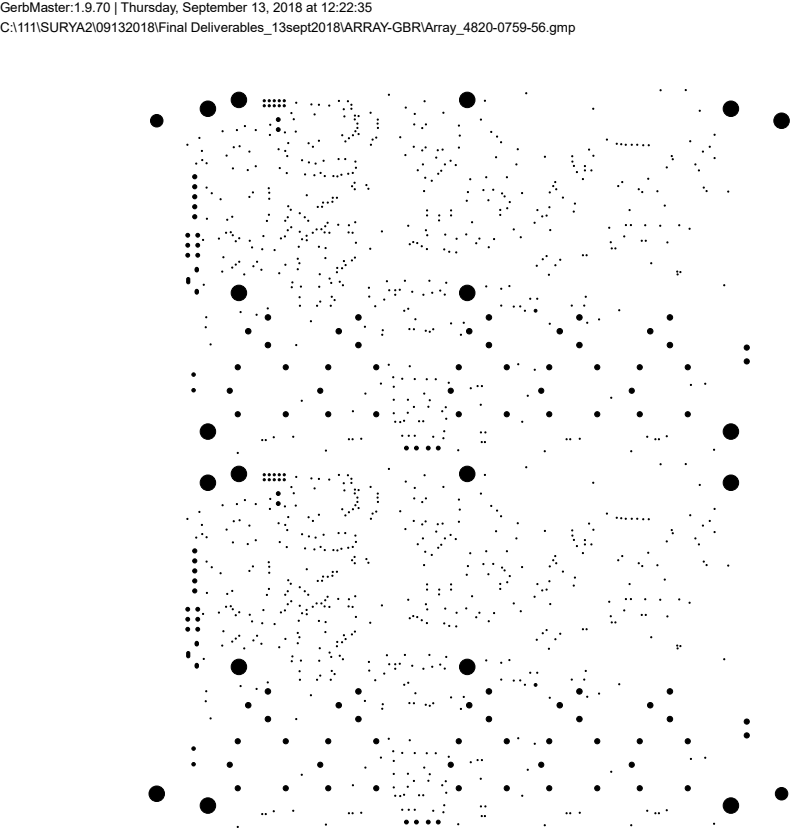
[picture p43: page 11]

GerbMaster:1.9.70 | Thursday, September 13, 2018 at 12:22:35
