waggle-sensor/wagman/(list of files, drawings)

Other design files:
boards/v1/pcb/wagman_v1-1.LYT
boards/v1/pcb/wagman_v1-2.LYT
