waggle-sensor/wagman/(commit log)

2015-07-01 changed SRAM test to assembly. still fighting with timers.
2015-07-06 still working on POST. timer test works maybe? its been inconsistent...I don't trust it.
2015-07-09 adding structure for boot sequences. POST now tests timer and interrupts individually.
2015-07-10 added a couple libraries. started a new sketch to verify operation of newly-minted WagMan boards. currently testing RTC...confused by roughly 96 year offset.
2015-07-13 switching to making Pete's requested features functional. added python script to interact with SysMon...first task is to receive request and send params to SysMon.
2015-07-16 params are now sent as two chunks: core params and guest node params. heartbeat detection works, but the pins do not match the schematic...confusing.
2015-07-17 very very confused. board does not match schematic. this commit is a semi-functional state with 1 relay, thermistor, photocell, and serial comms.
2015-07-22 adding current sensor parameters
2015-07-27 guest node boot sequence is written...needs verified. WagMan.py is now sending ADC temperature values...needs verified.
2015-07-28 added heartbeat file for node controller. corrected thermistor_LUT in WagMan.py. polished boot sequences a bit. working on main loop.
    [Thermistor ADC values.ods]
2015-08-03 Added code for periodically attempting to reboot non-running devices, as well as allowing the primary boot sequence to be attempted multiple times before SysMon goes to sleep. Reorganized code into m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
2015-08-03 moved Notes folder one directory up. added document for my WagMan test plan.
    [Thermistor ADC values.ods]
2015-08-04 Building Wagman evaluator, to test all components on board.
2015-08-05 added SoftReset Arduino library. working on SysMon testing.
2015-10-20 Adding Arduino Micro bootloader that the Wagman uses. Should add the original source and LUFA libraries and documentation to help build the bootloader from source.
2015-10-28 Some changes to makefiles, sensor codes etc.
2016-01-18 Just saving current progress.
2016-01-21 Progress, the board is fully functional - two bugs which were easily fixed.
2016-01-22 Sensor board code progress.
2016-01-26 Progress on sensor and wagman eval code.
2016-02-01 Separate V2 and V3 code for now.
    [Thermistor ADC values.ods]
2016-04-19 Minor edit
    [QA_Test.ods]
2016-04-28 added wagman ids collected from surya
    [board-ids.csv, original-board-ids.csv]
2016-06-02 added alphasense reference material
    [boards.csv, newids.csv]
2016-06-21 cleaned up device handling logic / added small command language for testing
2016-06-21 cleaned up Device
2016-06-24 cleaned up code and returning to implementing resilience piece after catching a (potentially serious but now seemingly resolved) bug with the watchdog.
    [Device.cpp, Device.h, MCP342X.cpp, Record.cpp, Record.h, Wagman.cpp, Wagman.h]
2016-06-27 simplified device design by moving back towards simple state machine
2016-06-28 forgot to add time check...fixed
    [Device.cpp, Device.h]
2016-06-28 extended ping command to serve as external heartbeat. command ping n1 n2 ... tells wagman that those devices seem to be alive
2016-06-28 fixed boot failure count
    [Device.cpp, Device.h]
2016-06-28 change unintuitive ping behavior + correctly initialized device configs
    [Device.cpp]
2016-06-29 added watchHeartbeat flag to allow some devices (like coresense) to ignore the heartbeat
2016-06-29 fixed boot media selection
    [Device.cpp]
2016-06-29 replaced timer with bytecount in processCommand. since we're processing potentially a large number of bytes rapidly, it's worth trying to fit into the 8-bit arithmetic of the atmel...
2016-06-29 more data type minimizations + added wait time for current sensor
2016-06-29 can specify if a device has current checking on.
2016-06-30 cleaning up persistant memory layout. moved particular state logic into their own functions...why didn't I do that before? :)
    [Device.cpp, Device.h, Record.cpp, Record.h, Wagman.cpp, Wagman.h]
2016-07-01 rewrote get address current to respect error codes and have bounded number of attempts.
    [Device.cpp, Device.h, HTU21D.cpp, HTU21D.h, Wagman.cpp]
2016-07-01 added current sensor error check in update fault function, allowing the function to ignore error values.
    [Device.cpp, HTU21D.cpp]
2016-07-05 forgot to add heartbeat / current checks back in
2016-07-06 move toward uniform error handling
    [MCP342X.cpp, Wagman.h]
2016-08-03 expanded on using boot flags to change start behavior. improved heartbeat detection using counter to reduce false heartbeats. (also used in detecting initial power state of node controller.)
2016-08-03 added a status summary to logger. (id, date, thermistor, current) this needs some unification with the commands to be cleaner / all in one place. but in the mean time, it provides a simple mechanism 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
2016-08-03 expanded init process to distinguish when toggling a relay probably a power fault vs a locked up processor. this allows us to be less harsh about disabling the device in the second case (since the lo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
2016-08-03 correct device enable command
    [Record.cpp]
2016-08-04 changed low current detection from kill to warn
2016-08-05 detects current states low, normal, stressed, high. these are only reported and not used to kill the device.
2016-08-11 has eeprom reset. has boot time logs soon to to used for start back off
    [Device.cpp, Device.h, Record.cpp, Record.h]
2016-08-12 enable / disable correction
    [Device.cpp, Device.h, Record.cpp, Record.h, Wagman.cpp, commands.cpp]
2016-08-12 performs initialize sensor checks
2016-08-12 handles incomplete relay flag on watchdog reset or external reset
    [Device.cpp]
2016-08-12 fixed mistake in device kill
    [Device.cpp, Device.h, Record.cpp, Record.h]
2016-08-16 cleaned up set next boot media + correct unmanaged mode
    [Device.cpp, Device.h, Wagman.cpp]
2016-08-16 added wire flag + nc bootloader flag and interfaces
2016-08-16 added Wire 'breaker' into Wagman interface
2016-08-16 isolated time / id into wagman and added utils to print date and id
2016-08-16 removed wire disable test
2016-08-17 Made some changes to the code that sets the flag in EEPROM for pre-booting the node controller in the bootloader stage.
2016-08-17 added times to reset and stop commands
    [Device.cpp, Device.h]
2016-08-17 wagman will not start devices once it's beginning it's reset
2016-09-02 Wagman bootloader source and binary.
    [ConfiguringApps.txt]
2016-09-27 Created hardware package for Arduino 1.6. Contains Wagman board with custom bootloader. This should make it much easier for someone to get started in setting up a Wagman.
2016-11-04 Commented out CLEANSLATE flag by default... Sets boot media earlier to allow reboot into media.
    [Device.cpp, Record.h]
2016-12-01 reset startTimer after a device kill
    [Device.cpp, Wagman.h]
2016-12-01 Progress on the corner case. Prevents a situation where a node being shutdown is started soon enough that the relays do not entirely turn the device off. A restart after a shutdown will take a minimu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
2016-12-01 Fixed a make file bug, version info bug in verinfo.cpp and Wagman.ino.
    [verinfo.cpp]
2016-12-02 Changes to the bootloader and the Wagman firmware to enable the wagman firmware to read the reason for its reboot.
    [Caterina.c]
2016-12-05 Fixed printID half-byte order
2016-12-05 Trimmed printID to 6 bytes instead of 8 bytes to match printed label.
2016-12-20 Some QA testing reorg
    [QA_Test.ods, board-ids.csv, boards.csv, newids.csv, original-board-ids.csv]
2016-12-20 Progress on shrinkingthe test suit.
    [board-ids.csv, boards.csv, newids.csv, original-board-ids.csv]
2016-12-22 get MAC addr of Wagman
    [wagman.csv]
2016-12-22 found missing one
    [wagman.csv]
2017-01-05 Bootloader installer script. This script uses a slow speed initial step to set the fuses and then installs the bootloader again using the second step.
2017-03-18 Updates to Wagman Code Organization.
    [Thermistor ADC values.ods]
2017-03-18 WagMan case changes.
2017-03-31 Script to check device info.
2017-03-31 Converted to allow optional device argument.
2017-03-31 Added optional argument for device info.
2017-04-07 Set / prints date. Prints version. Resets EEPROM.
2017-05-08 wagman setup supports device parameter now. added longer delay before wminit
2018-03-20 forgot to specify device flag
2018-10-22 set due adc to 12 bit resolution and ported thermistor readings to analog pins.
2018-10-22 fixed boot select pins
    [Wagman.cpp, Wagman.h, firmware.ino]
2018-10-29 upped version number, fixed old state bug, fixed baseline current levels for leds.
    [Device.cpp, Wagman.cpp, firmware.ino, verinfo.cpp]
2018-10-29 updated htu21d library to match the version used in sensor tests. seems to have fixed readings.
    [HTU21D.cpp, HTU21D.h]
2018-12-17 moved watchdogEnable sequence into setup rather than watchdogSetup hook. added a couple additional watchdogResets to setup().
2019-01-18 disable auto status log to avoid accessing various busses and sensors
    [firmware.ino]
2019-01-23 added raw temperature / humidity
2019-01-23 added raw temperature / humidity / light + error message on sensor fault
    [HTU21D.cpp, HTU21D.h, Wagman.cpp, Wagman.h, firmware.ino]
2019-05-10 commiting custom waggle boards for arduino ide
2019-05-15 adding reset all function
    [firmware.ino]
2019-05-15 fixed led index
2019-05-17 formatted + fixed heartbeat bug
    [firmware.ino]
2019-05-22 cleanup non-starting corner case - should not affect new wagman, but just in case
2019-05-22 using full 16-bit current value
2019-08-20 upped failure threshold to be about 1 week of constant failures
    [Device.cpp]
2019-12-04 fixed v3 and v4 firmware using new protocol
    [firmware.ino]
2019-12-09 fixed msgbuf in use
    [firmware.ino]
2019-12-09 fixed command port table
    [firmware.ino]
2020-04-24 added board info to README
2020-06-19 [SAGE-212] adding eWaggle library to firmware builder. need to pin to specific version
2022-05-31 Reorganizing board files
    [ConfiguringApps.txt, QA_Test.ods, Thermistor ADC values.ods, Wagman_V4_Atmel_Pin_Mapping.csv, board-ids.csv, boards.csv, newids.csv, original-board-ids.csv]
2022-05-31 Reorganizing Wagman V2 files.
    [Thermistor ADC values.ods]
2022-05-31 Organizing repos.
    [QA_Test.ods, board-ids.csv, boards.csv, newids.csv, original-board-ids.csv, wagman.csv, wagman_v1-1.LYT, wagman_v1-2.LYT]
2022-05-31 v5 pcb files
